luisldealba-ai/Ajobot/README.md

# Ajobot

Este repositorio contiene el diseño mecánico y los archivos de manufactura para el chasis de un robot móvil (Omni-wheel Rover) inspirado en la morfología del **Ajolote de Montaña (*Ambystoma altamirani*)**.

<p align="center">
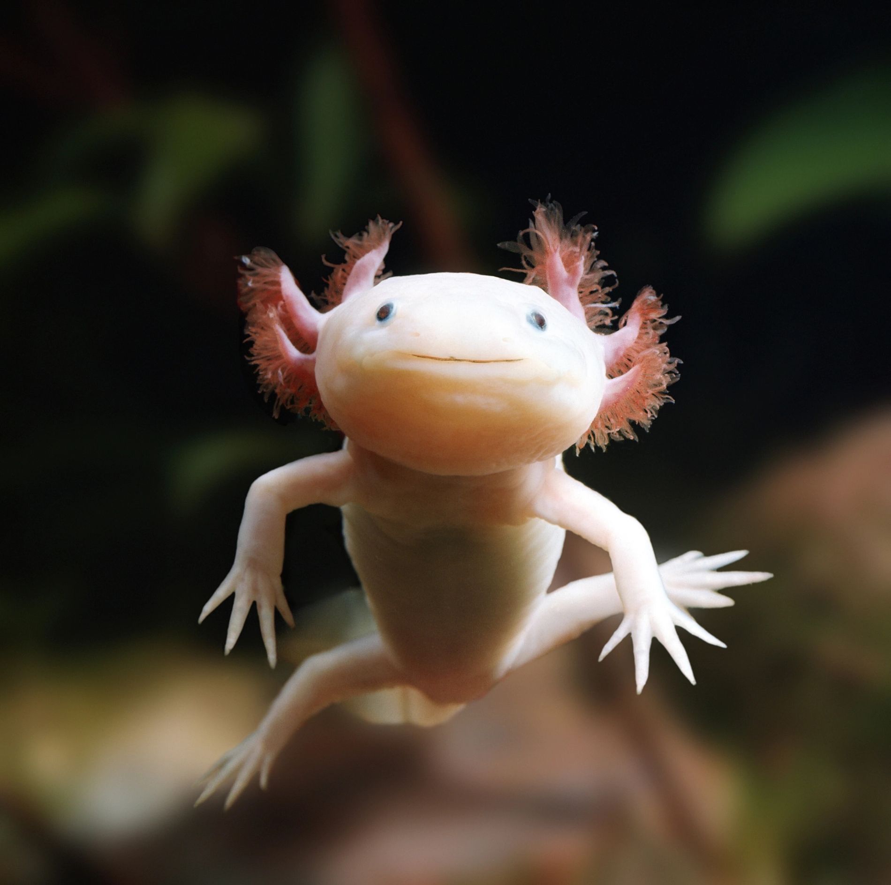
[picture p1: Mecanica/Documento/ajobot.jpeg]
  
</p>

Este proyecto documenta el proceso de diseño desde el concepto inicial en papel hasta el modelo 3D final  para cuando se mande a corte láser.

##  Evolución del Diseño
El diseño final es el resultado de un proceso de abstracción geométrica:
1.  **Concepto Original:** Inspirado en la silueta y la cresta dorsal del ajolote de montaña.
2.  **Abstracción 2D:** Descomposición de las formas orgánicas en figuras geométricas aptas para manufactura.
3.  **Modelo Final:** Chasis estructural de dos niveles conectado por columnas rígidas, optimizando el espacio para motores, baterías y controladores.

## Especificaciones Técnicas
* **Material:** MDF de 3mm y Acrílico Claro de 3mm (Grosor verificado de 0.3cm en modelo).
* **Estructura:** Doble placa (Base y Top) con soportes verticales.
* **Manufactura:** Preparado para corte láser mediante archivos vectoriales (DXF/SVG). 
* **Precisión:** Escala real aplicada (1:1) para asegurar la compatibilidad con componentes electrónicos estándar.

## Softwares Utilizados 
<p align="center">
  
  
</p>
