luisldealba-ai/Ajobot/Diseño de la PCB/Kicad/README.md

# Resumen

Aquí veras todo lo relacionado con el esquemático, el diseño que se realizo para PCB y los componentes que se utilizaron para poder lograr que nuestro Ajobot ya sea un vehículo independiente.
