luisldealba-ai/Ajobot/Mecanica/Fusión 360/Estudios/README.md

Aqui veras todos los estudios realizados para cierto tipo de materiales designados (MDF y Acrílico)
