luisldealba-ai/Ajobot/Mecanica/Exportar Formato/README.md

# Exportar diseño a formato DXF
Aqui estan los archivos de cada nivel (Base y Top) ya en formato DXF, 
También dejare la forma de como se guarda y desde que sitio Web se utilizo para visualizarlo de manera gratuita.
[[!Video de Demostración ](https://youtu.be/9-rpbkoBJIk?si=gKVBWkLFkaAhzoEW)]
# Sitio Web Gratituo Utilizado
<p align="center">
  
</p>
