luisldealba-ai/Ajobot/Mecanica/Fusión 360/Diseño Final/README.md

# Diseño 
Esto es como se vería el diseño a como se lleva actual 
27/9/2026
