luisldealba-ai/Ajobot/Mecanica/Fusión 360/Top Medidas/README.md

# Medidas Top (2 de 2)

Aquí estarán las imágenes relacionadas con las medidas de la segunda placa del diseño. 

PD: Recordar que cualquier medida vista en las imágenes forman parte del sistema métrico decimal que están establecidas por el Sistema Internacional de Unidades(SI) en la escala de milímetros (mm).
