luisldealba-ai/Ajobot/Mecanica/Fusión 360/Base Medidas/README.md

# Medidas Base (1 de 2) 
Aquí veras las imágenes relacionadas con las medidas de la base.

PD: Recordar que cualquier medida vista en las imágenes forman parte del sistema métrico decimal que están establecidas por el Sistema Internacional de Unidades(SI) en la escala de milímetros (mm).
