luisldealba-ai/Ajobot/Mecanica/Fusión 360/Base Medidas/Base 0.1.png

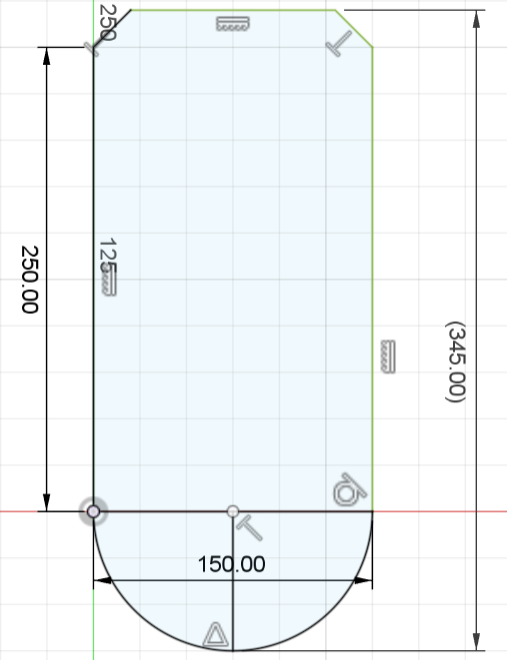
Mecanica/Fusión 360/Base Medidas/Base 0.1.png
