luisldealba-ai/Ajobot/Mecanica/Fusión 360/Base Medidas/Base 0.6.png

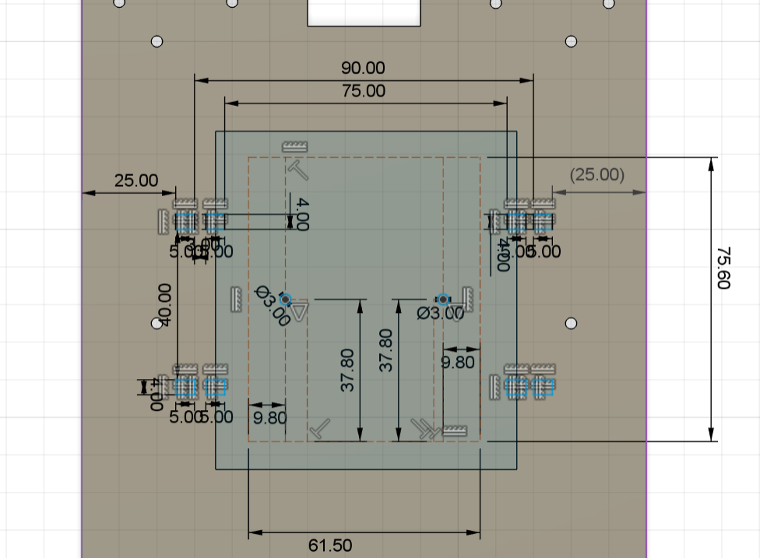
Mecanica/Fusión 360/Base Medidas/Base 0.6.png
