luisldealba-ai/Ajobot/Mecanica/Fusión 360/Base Medidas/Base 1.0.png

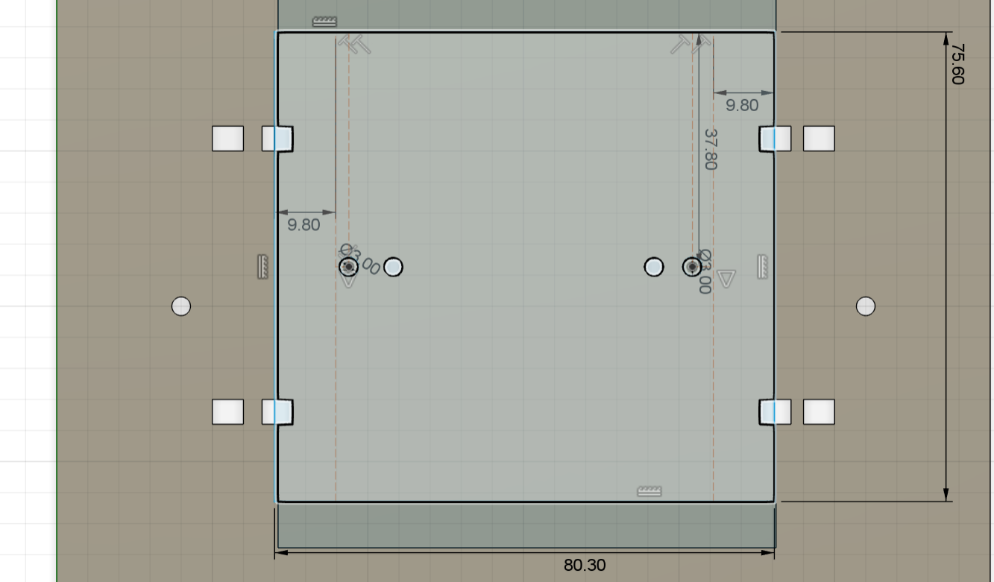
Mecanica/Fusión 360/Base Medidas/Base 1.0.png
