luisldealba-ai/Ajobot/Mecanica/Fusión 360/Diseño Final/1.png

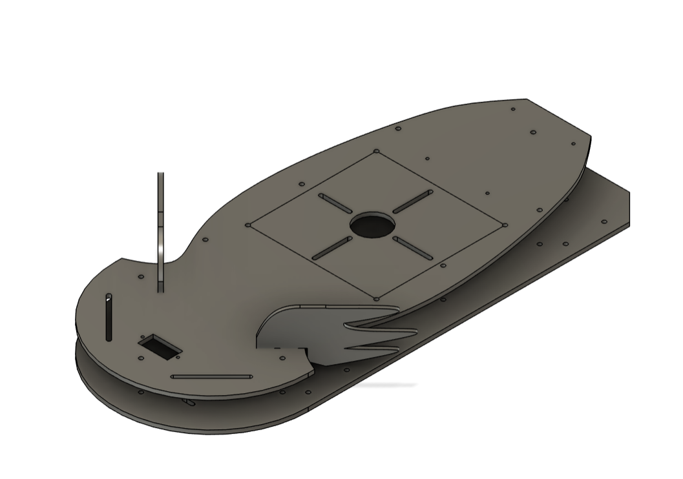
Mecanica/Fusión 360/Diseño Final/1.png
