luisldealba-ai/Ajobot/Mecanica/Fusión 360/Diseño Final/2.png

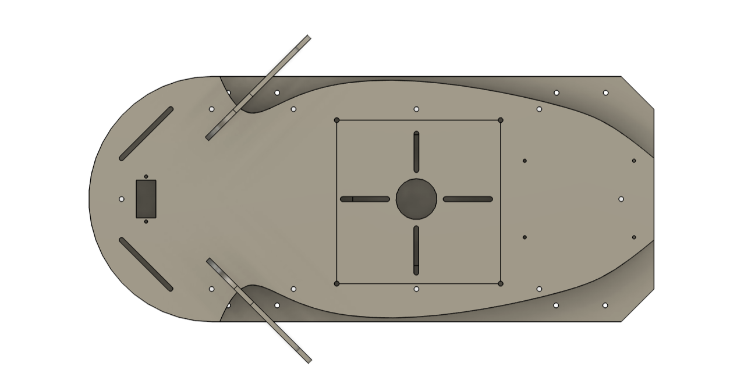
Mecanica/Fusión 360/Diseño Final/2.png
