luisldealba-ai/Ajobot/Mecanica/Fusión 360/Diseño Final/3.png

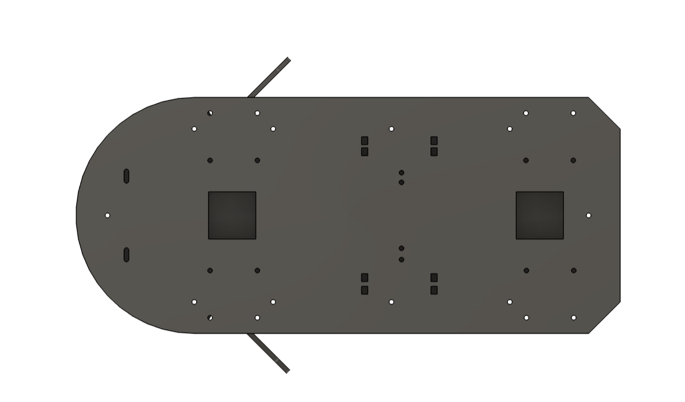
Mecanica/Fusión 360/Diseño Final/3.png
