luisldealba-ai/Ajobot/Mecanica/Fusión 360/Diseño Final/4.png

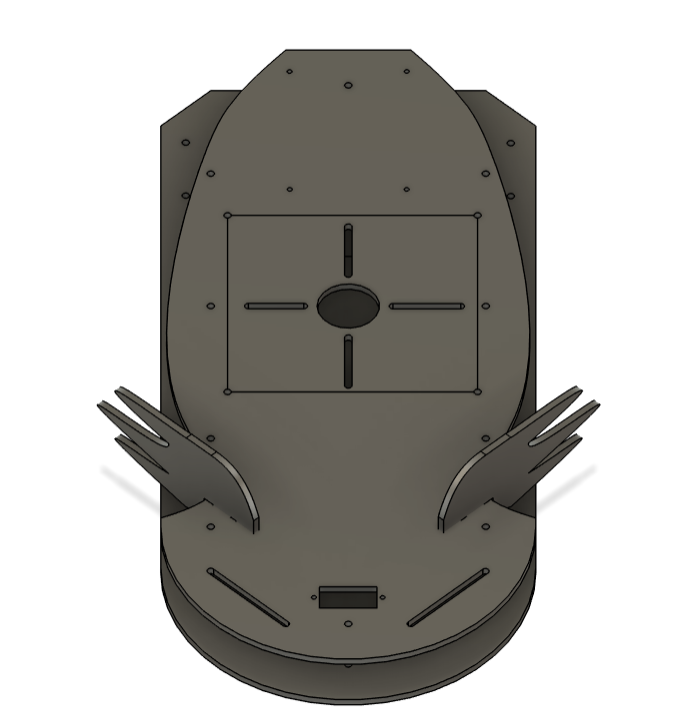
Mecanica/Fusión 360/Diseño Final/4.png
