luisldealba-ai/Ajobot/Mecanica/Fusión 360/Top Medidas/Captura de pantalla 2026-10-04 183150.png

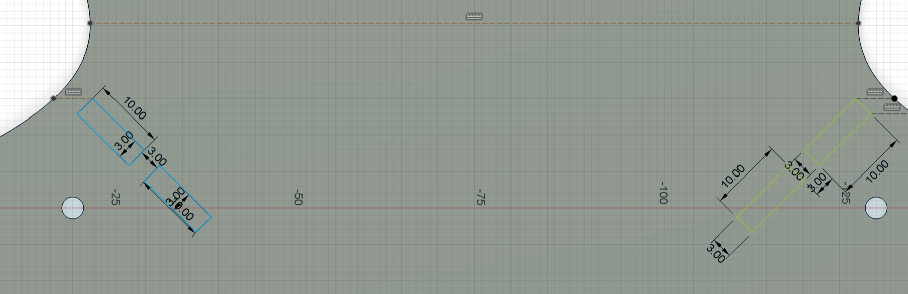
Mecanica/Fusión 360/Top Medidas/Captura de pantalla 2026-10-04 183150.png
