luisldealba-ai/Ajobot/Mecanica/Fusión 360/Top Medidas/imagen_2026-10-04_183643530.png

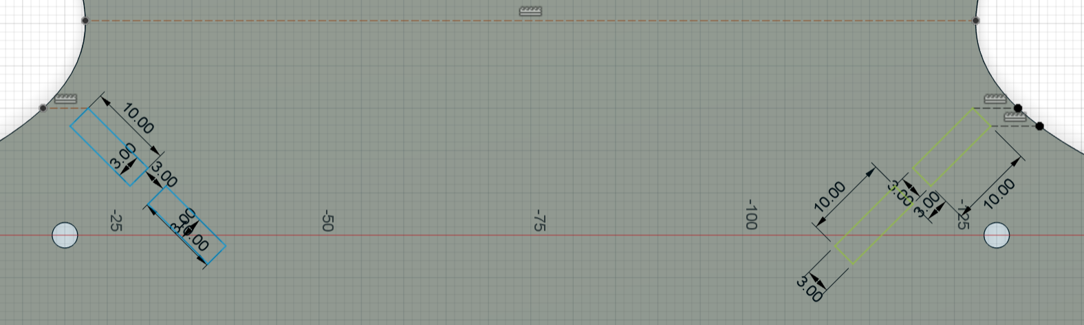
Mecanica/Fusión 360/Top Medidas/imagen_2026-10-04_183643530.png
