luisldealba-ai/Ajobot/Mecanica/Fusión 360/Top Medidas/Top 0.2.png

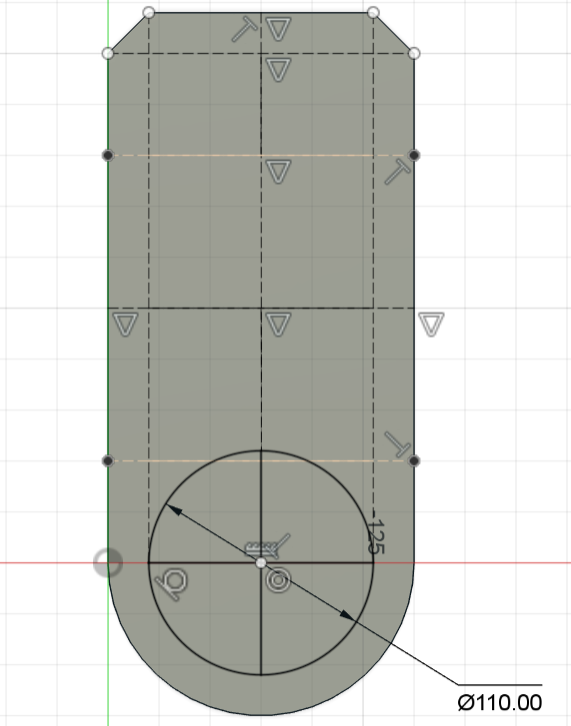
Mecanica/Fusión 360/Top Medidas/Top 0.2.png
