luisldealba-ai/Ajobot/Mecanica/Fusión 360/Top Medidas/Top 0.5.png

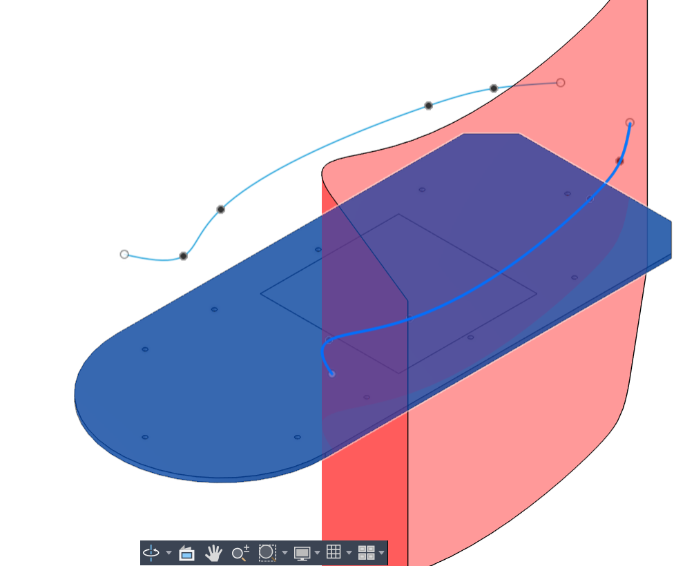
Mecanica/Fusión 360/Top Medidas/Top 0.5.png
