luisldealba-ai/Ajobot/Mecanica/Fusión 360/Top Medidas/Top 0.6.png

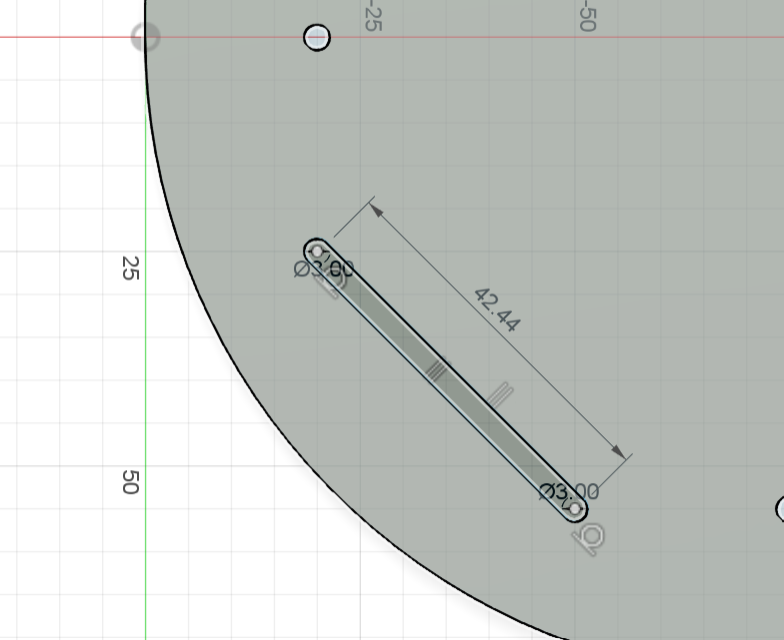
Mecanica/Fusión 360/Top Medidas/Top 0.6.png
