luisldealba-ai/Ajobot/Mecanica/Fusión 360/Top Medidas/Top 0.7.png

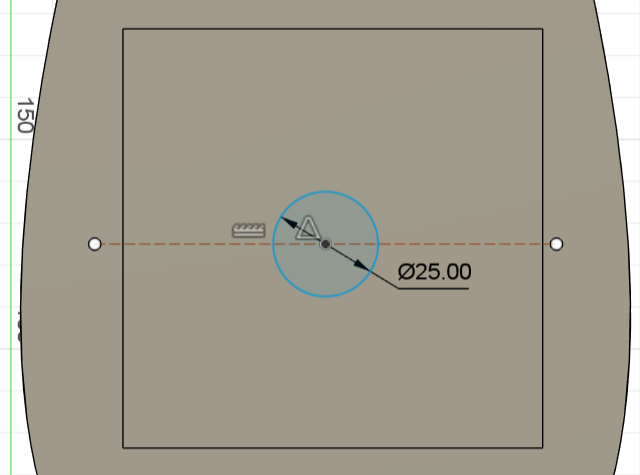
Mecanica/Fusión 360/Top Medidas/Top 0.7.png
