luisldealba-ai/Ajobot/Mecanica/Fusión 360/Top Medidas/Top 0.9.png

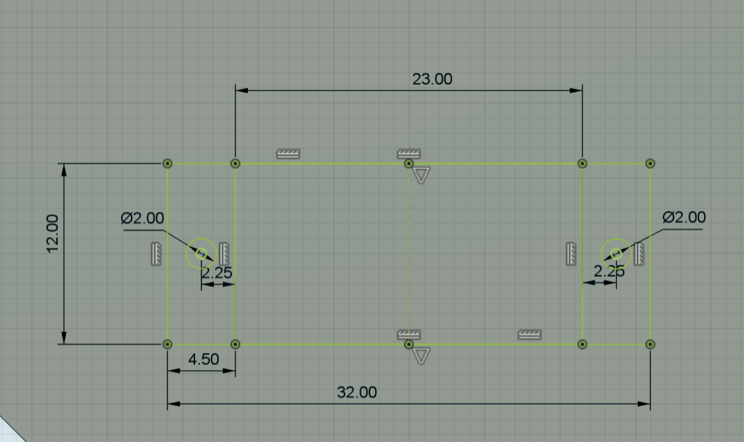
Mecanica/Fusión 360/Top Medidas/Top 0.9.png
