luisldealba-ai/Ajobot/Mecanica/Fusión 360/Top Medidas/Top 1.0.png

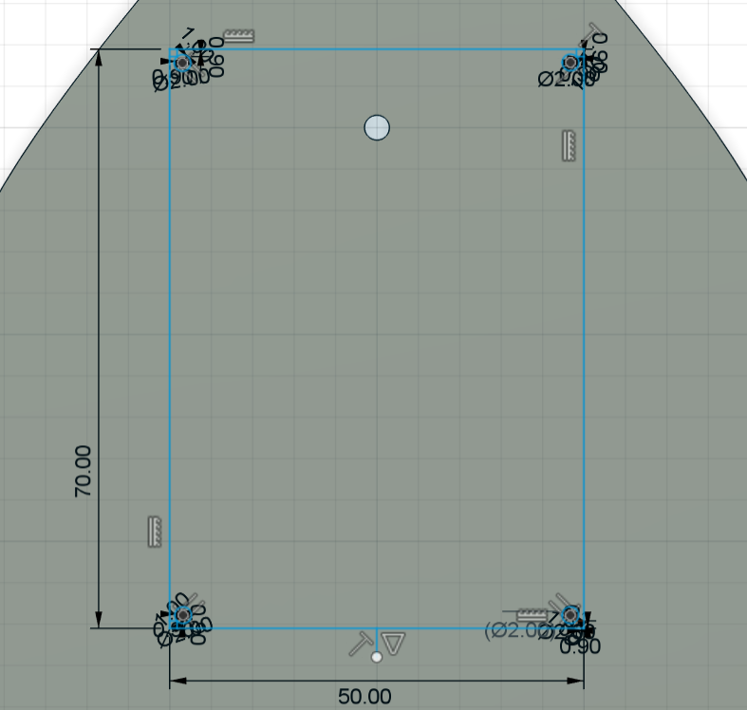
Mecanica/Fusión 360/Top Medidas/Top 1.0.png
