luisldealba-ai/Ajobot/Mecanica/Exportar Formato/Base DXF.dxf

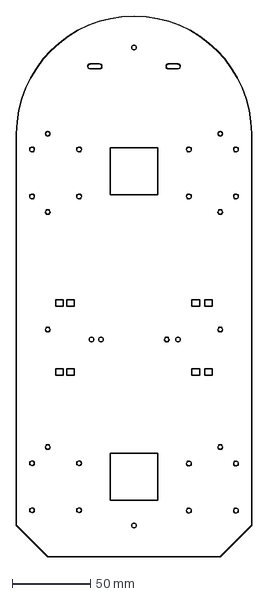
[picture p28: CAD file, 2026-10-05]
Mecanica/Exportar Formato/Base DXF.dxf
150.0 x 345.0 mm
