luisldealba-ai/Ajobot/Mecanica/Exportar Formato/Top DXF.dxf

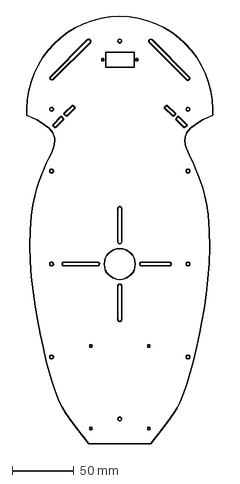
[picture p29: CAD file, 2026-10-05]
Mecanica/Exportar Formato/Top DXF.dxf
150.5 x 345.0 mm
