luisldealba-ai/Ajobot/Mecanica/Fusión 360/Base Medidas/Base Pruebas.png

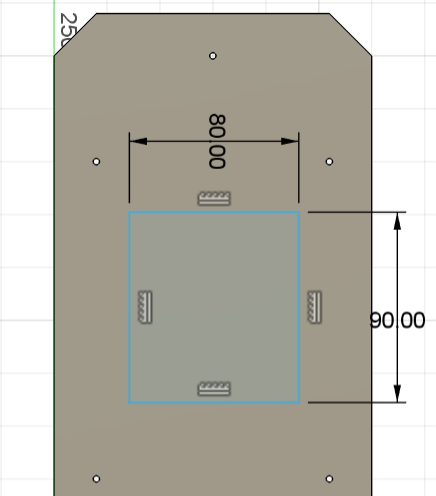
Mecanica/Fusión 360/Base Medidas/Base Pruebas.png
