luisldealba-ai/Ajobot/(commit log)

2026-10-02 Revise technical specifications and remove Blender section
    Updated modeling software and materials specifications, and removed Blender-specific methodology section.
2026-10-02 Revise material specs and add software used section
    Updated material description and added software section with badges.
2026-10-04 Create README.md for Top Medidas
    Added a README file for the second plate measurements.
2026-10-04 Rename Captura de pantalla 2026-10-02 195101.png to Base 0.1.png
2026-10-04 Add files via upload
    Nota: Como bien dice el nombre de la foto, estas medidas de este rectángulo se utilizaron para poder hacer pruebas de simulación de resistencia en esa área respectivamente, no es necesario dejarlo.
2026-10-04 Add files via upload
    1 de 2 base de los tornillos para los motores
2026-10-04 Add files via upload
    2 de 2 base para los tornillos
2026-10-04 Add files via upload
    Cuadrado para el paso de los cables de los motores a utilizar
2026-10-04 Add files via upload
    Por si el usuario quiere utilizar un porta pilas, estas son las medidas para uno de 4 o 3 pilas(hablamos de un porta pilas para el 18650, donde es mas utilizado en proyectos).
2026-10-04 Add files via upload
    PD: Estas modificaciones fueron hechas para poder utilizar cinchos para poder sujetar o darle esa seguridad a la fuente de que no se mueva
2026-10-04 Add files via upload
    Son las medidas de un porta pilas de 3 ranuras del tipo 18650
2026-10-05 Rename Captura de pantalla 2026-10-04 183150.png to Top 1.2.png
2026-10-05 Rename Captura de pantalla 2026-10-04 185329.png to 1.png
2026-10-05 Rename Captura de pantalla 2026-10-04 185358.png to 2.png
2026-10-05 Rename Captura de pantalla 2026-10-04 185417.png to 3.png
2026-10-05 Rename Captura de pantalla 2026-10-04 185452.png to 4.png
2026-10-08 Add files via upload
    Estudio de la Base
